kamikite/FeurIO/(list of files, drawings)

Other design files:
FeurIO.fzz
