kamikite/FeurIO/(commit log)

2016-09-30 add IO Test Script
    Sensor Test (IR, Foto,Temp)
2016-09-30 change photo sensor value
2016-10-03 add FeurIO circuit
    with Fritzing
    [FeurIO.fzz]
2016-10-04 renaming some functions, refactoring, fix some delay bugs
    [FeurIO.ino]
